lle/Arduino-Robot-Shield/gerber/version1c.TXT

%
M48
M72
T01C0.0276
T02C0.0394
T03C0.0400
T04C0.0470
T05C0.0472
%
T01
X8750Y6300
X8750Y7450
X9250Y7700
X9750Y6700
X11250Y7950
X11750Y8200
X12250Y8950
X9750Y17200
X7250Y19200
X9750Y21200
X7250Y23200
X12250Y23200
X14750Y21200
X16250Y22200
X17250Y21200
X14750Y17200
X12250Y19200
T02
X20250Y18700
X20250Y17700
X20250Y16700
X20250Y15700
X20250Y19700
X20250Y20700
X20250Y22700
X20250Y23700
X20250Y24700
X20250Y25700
X20250Y26700
X20250Y27700
X1250Y27700
X1250Y26700
X1250Y25700
X1250Y24700
X1250Y23700
X1250Y22700
X1250Y21700
X1250Y20700
X1250Y19100
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
