lle/Arduino-Robot-Shield/Arduino_motorSheild.xlsx

Sheet: PCB Specs
PCB Specs
http://www.pcbcart.com/
Material | FR4 | Quantity / Lead time | in 8 days (*) | in 12 days
Material Details | Standard Tg 140C | 20 | $3.32 | $3.17
Board Size (width) * | 70 mm | 5 | $10.95 | $10.45
Quantity * | 20 pcs | 10 | $5.64 | $5.39
Route Process * | -- | 15 | $3.98 | $3.80
Surface Finish | HASL -Hot Air Solder Leveling | 20 | $3.32 | $3.17
Min. Tracing/Spacing | 0.20 mm | 25 | $2.81 | $2.68
Smallest Holes | 0.40 mm | 30 | $2.48 | $2.36
Surface Mount | 1 side | 40 | $2.06 | $1.97
Peelable Soldermask | None | 50 | $1.81 | $1.73
Matt Color (only add to Green or Black) | None | 75 | $1.55 | $1.47
Silkscreen Legend Color | White
Gold Fingers Chamfer | None
Testing | Yes
Date Code Marking * | No
PCB specification file | ???
Layers | 2
Reorder Status * | --
Board Size (height) * | 60 mm
Different Design in Panel * | --
Thickness (Finished Board) | 1.6 mm
Copper Weight (Finished) | 35 um
Min. Annular Ring | 0.30 mm
Holes Numbers | Under 300
Soldermask | Both Sides
Soldermask Color | Blue
Silkscreen Legend | 1 side
Gold Fingers | No
Slots/cutouts in Board | No Slot in Board
UL Marking * | No
Lead Time | in 8 days

Sheet: Inventory
Bill of Material
 | Total Asset | 437.618 |  |  | Test
 | Price/Kit | 10.71008 |  |  | Item Sold | 40
 | Sale Price | $15.99 |  |  | Income | $639.60
 | Profit Margin | $5.28 | 49.29860468% |  | Profit | $201.98
Item | Part No | Store | Price/unit | Qty | Sub-total | Qty/kit | Unit/price in Kit | URL
PCB |  | pcbcart | 2.06 | 40 | $152.54 | 1 | $3.81 | http://www.pcbcart.com/
Diode 1N4001 | 641-1310-1-ND | Digikey | 0.03406 | 500 | $17.03 | 8 | $0.27 | http://www.digikey.ca/product-detail/en/1N4001-G/641-1310-1-ND/1979675
L298 | 497-1395-5-ND | Digikey | 4.0272 | 40 | $161.09 | 1 | $4.03 | http://www.digikey.ca/product-detail/en/L298N/497-1395-5-ND/585918
Male-Male Header (40)(3/kit) | S1212EC-40-ND | Digikey | 0.4577 | 100 | $45.77 | 3 | $1.37 | http://www.digikey.ca/product-detail/en/PREC040SFAN-RC/S1212EC-40-ND/2774934
ScrewBolt Connector (4)(1/kit) | ED2563-ND | Digikey | 0.718 | 50 | $35.90 | 1 | $0.72 | http://www.digikey.ca/product-detail/en/OSTTA040161/ED2563-ND/614513
Capacitor 100uF Electrolytic 25V | 399-6103-ND | Digikey | 0.0804 | 50 | $4.02 | 1 | $0.08 | http://www.digikey.ca/product-detail/en/ESK107M025AE3AA/399-6103-ND/2712509
Capacitor 1uF Ceramic 25V | 445-2857-ND | Digikey | 0.2127 | 100 | $21.27 | 2 | $0.43 | http://www.digikey.ca/product-detail/en/FK24X7R1E105K/445-2857-ND/1008883

Sheet: Kit
Kit Part List
Item
PCB | 1
L298 | 1
Diode | 8
Male-Male Header | 1 | At least 86 positions
ScrewBolt Connector | 1 | 4 bolts
Capacitor 100uF Electrolytic 25V | 1
Capacitor 1uF Ceramic 25V | 2
