lle/Arduino-Robot-Shield/version1c.brd

## EAGLE design version1c.brd (2014-05-17)

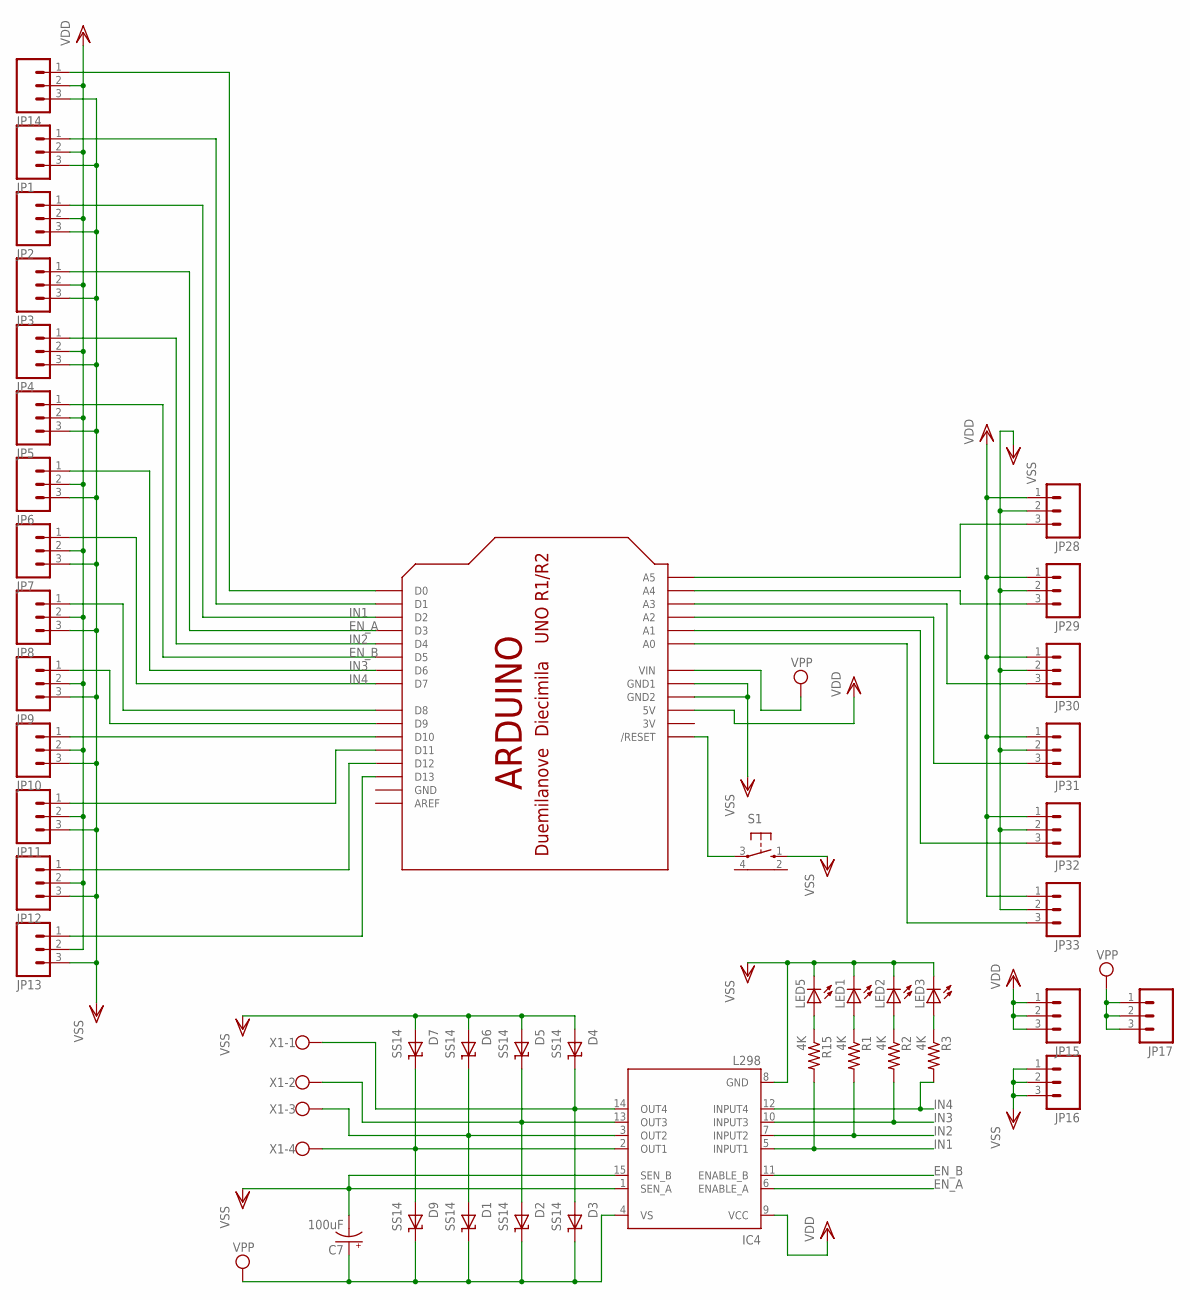
[picture p1: schematic version1c.sch]

Parts:
C7: 100uF; 153CLV-0605
D1, D2, D3, D4, D5, D6, D7, D9: SS14; SMA
IC4: L298; MULTIWATT-15
JP1, JP2, JP3, JP4, JP5, JP6, JP7, JP8, JP9, JP10, JP11, JP12, JP13, JP14, JP15, JP16, JP17, JP28, JP29, JP30, JP31, JP32, JP33: M03PTH; 1X03
LED1, LED2, LED3, LED5: LEDCHIP-LED0805; CHIP-LED0805
R1, R2, R3, R15: 4K; R0805
S1: 10-XX-RPAD; B3F-10XX-RPAD
U$1: ARDUINO-NOHOLE
X1: W237-4

Connections:
3V: U$1.3V
EN_A: IC4.6 (ENABLE_A), JP3.1, U$1.D3
EN_B: IC4.11 (ENABLE_B), JP5.1, U$1.D5
GND: U$1.GND
IN1: IC4.5 (INPUT1), JP2.1, R15.2, U$1.D2
IN2: IC4.7 (INPUT2), JP4.1, R1.2, U$1.D4
IN3: IC4.10 (INPUT3), JP6.1, R2.2, U$1.D6
IN4: IC4.12 (INPUT4), JP7.1, R3.2, U$1.D7
unnamed: JP13.1, U$1.D13
unnamed: JP12.1, U$1.D12
unnamed: JP28.3, U$1.A5
unnamed: JP11.1, U$1.D11
unnamed: JP10.1, U$1.D10
unnamed: JP29.3, U$1.A4
unnamed: JP9.1, U$1.D9
unnamed: JP8.1, U$1.D8
unnamed: JP30.3, U$1.A3
unnamed: LED3.A, R3.1
unnamed: LED2.A, R2.1
unnamed: JP31.3, U$1.A2
unnamed: LED1.A, R1.1
unnamed: LED5.A, R15.1
unnamed: JP33.3, U$1.A0
unnamed: JP32.3, U$1.A1
unnamed: JP1.1, U$1.D1
unnamed: JP14.1, U$1.D0
unnamed: S1.3, U$1.RESET (/RESET)
unnamed: D7.P$1 (K), D9.P$2 (A), IC4.2 (OUT1), X1.4
unnamed: D1.P$2 (A), D6.P$1 (K), IC4.3 (OUT2), X1.3
unnamed: D2.P$2 (A), D5.P$1 (K), IC4.13 (OUT3), X1.2
unnamed: D3.P$2 (A), D4.P$1 (K), IC4.14 (OUT4), X1.1
VDD: IC4.9 (VCC), JP1.2, JP2.2, JP3.2, JP4.2, JP5.2, JP6.2, JP7.2, JP8.2, JP9.2, JP10.2, JP11.2, JP12.2, JP13.2, JP14.2, JP15.1, JP15.2, JP15.3, JP28.1, JP29.1, JP30.1, JP31.1, JP32.1, JP33.1, U$1.5V
VPP: C7.+, D1.P$1 (K), D2.P$1 (K), D3.P$1 (K), D9.P$1 (K), IC4.4 (VS), JP17.1, JP17.2, JP17.3, U$1.VIN
VSS: C7.-, D4.P$2 (A), D5.P$2 (A), D6.P$2 (A), D7.P$2 (A), IC4.1 (SEN_A), IC4.8 (GND), IC4.15 (SEN_B), JP1.3, JP2.3, JP3.3, JP4.3, JP5.3, JP6.3, JP7.3, JP8.3, JP9.3, JP10.3, JP11.3, JP12.3, JP13.3, JP14.3, JP16.1, JP16.2, JP16.3, JP28.2, JP29.2, JP30.2, JP31.2, JP32.2, JP33.2, LED1.C, LED2.C, LED3.C, LED5.C, S1.1 (S), U$1.GND1, U$1.GND2

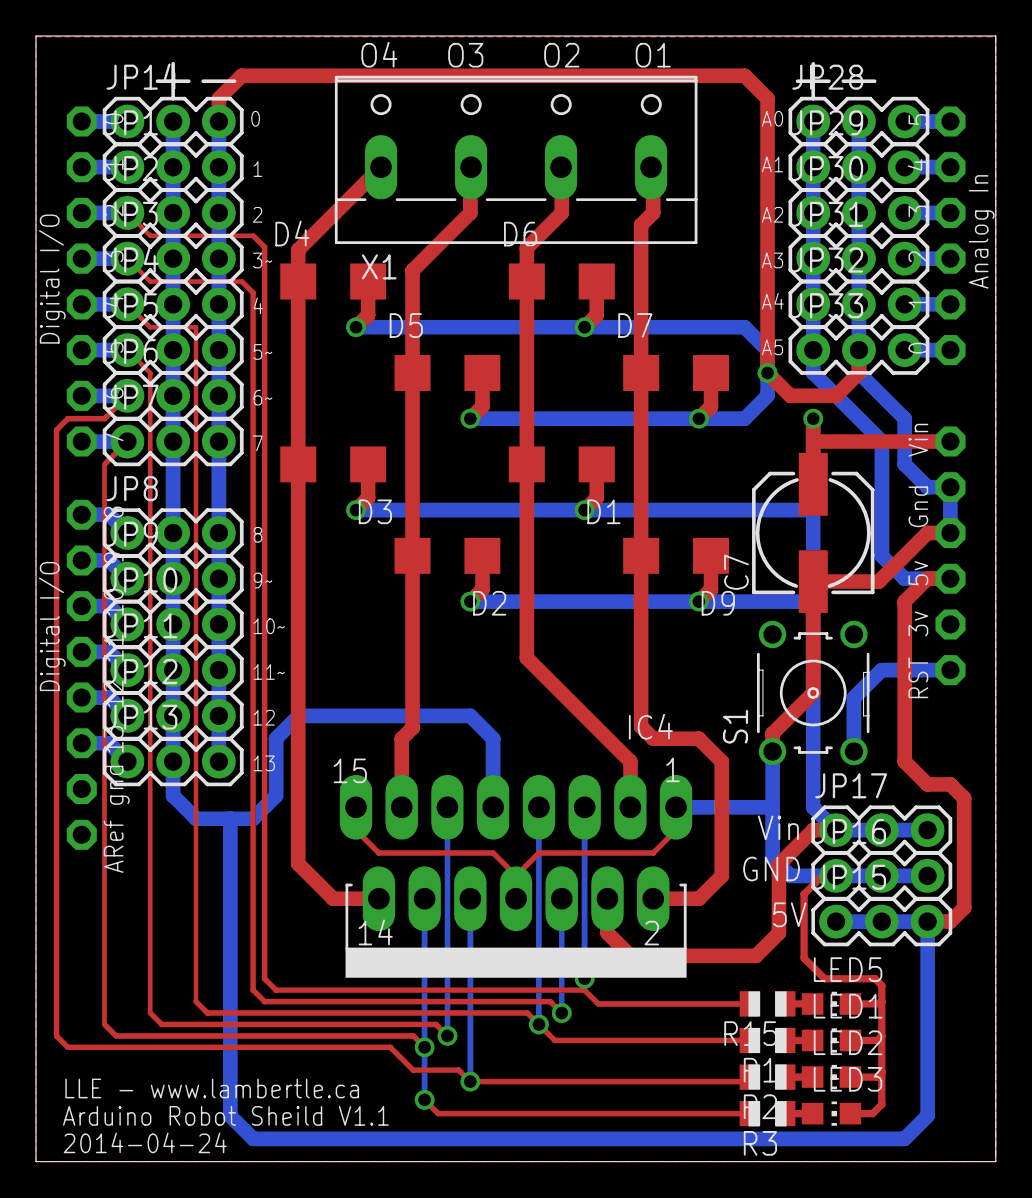
[picture p2: board version1c.brd from above]

Board: 2 copper layers, 53.3 x 62.5 mm, 44 parts (0 on the bottom side), 32 nets.
