lle/Arduino-Robot-Shield/version1.brd

## EAGLE design version1.brd (2014-04-19)

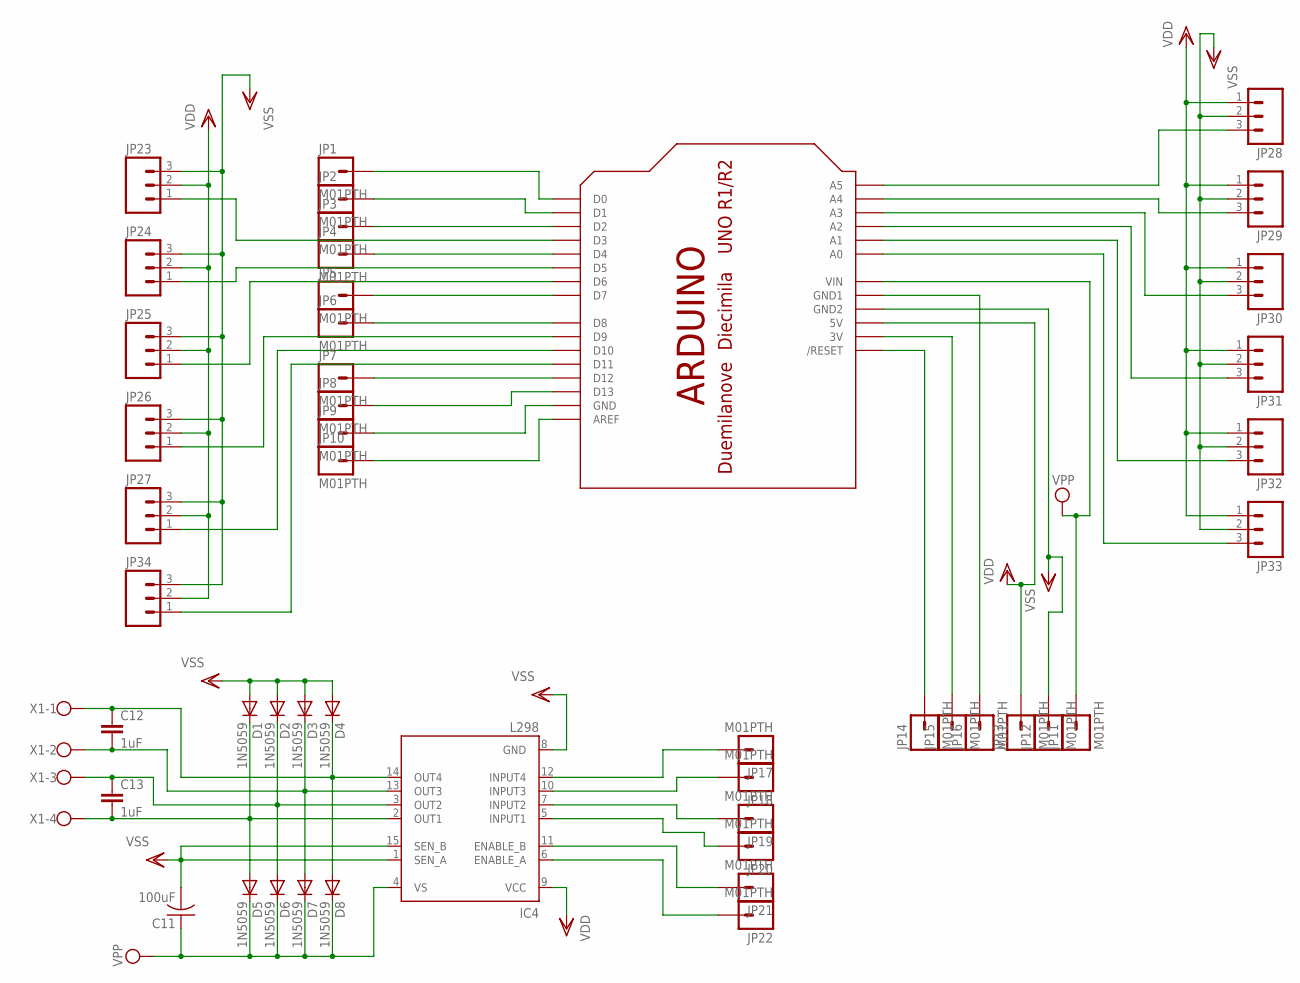
[picture p3: schematic version1.sch]

Parts:
C11: 100uF; C050-025X075
C12, C13: 1uF; C050-025X075
D1, D2, D3, D4, D5, D6, D7, D8: 1N5059; DO204-10
IC4: L298; MULTIWATT-15
JP1, JP2, JP3, JP4, JP5, JP6, JP7, JP8, JP9, JP10, JP11, JP12, JP13, JP14, JP15, JP16, JP17, JP18, JP19, JP20, JP21, JP22: M01PTH; 1X01
JP23, JP24, JP25, JP26, JP27, JP28, JP29, JP30, JP31, JP32, JP33, JP34: M03PTH; 1X03
U$1: ARDUINO-NOHOLE
X1: W237-4

Connections:
unnamed: JP1.1, U$1.D0
unnamed: JP2.1, U$1.D1
unnamed: JP28.3, U$1.A5
unnamed: JP3.1, U$1.D2
unnamed: JP4.1, U$1.D4
unnamed: JP29.3, U$1.A4
unnamed: JP5.1, U$1.D7
unnamed: JP6.1, U$1.D8
unnamed: JP30.3, U$1.A3
unnamed: JP7.1, U$1.D12
unnamed: JP8.1, U$1.D13
unnamed: JP31.3, U$1.A2
unnamed: JP9.1, U$1.GND
unnamed: JP23.1, U$1.D3
unnamed: JP24.1, U$1.D5
unnamed: JP33.3, U$1.A0
unnamed: JP32.3, U$1.A1
unnamed: JP10.1, U$1.AREF
unnamed: JP14.1, U$1.RESET (/RESET)
unnamed: JP25.1, U$1.D6
unnamed: JP15.1, U$1.3V
unnamed: JP16.1, U$1.GND1
unnamed: JP27.1, U$1.D10
unnamed: C13.2, D1.C, D5.A, IC4.2 (OUT1), X1.4
unnamed: C13.1, D2.C, D6.A, IC4.3 (OUT2), X1.3
unnamed: JP34.1, U$1.D11
unnamed: C12.2, D3.C, D7.A, IC4.13 (OUT3), X1.2
unnamed: C12.1, D4.C, D8.A, IC4.14 (OUT4), X1.1
unnamed: IC4.6 (ENABLE_A), JP22.1
unnamed: JP26.1, U$1.D9
unnamed: IC4.11 (ENABLE_B), JP21.1
unnamed: IC4.12 (INPUT4), JP17.1
unnamed: IC4.10 (INPUT3), JP18.1
unnamed: IC4.7 (INPUT2), JP19.1
unnamed: IC4.5 (INPUT1), JP20.1
VDD: IC4.9 (VCC), JP13.1, JP23.2, JP24.2, JP25.2, JP26.2, JP27.2, JP28.1, JP29.1, JP30.1, JP31.1, JP32.1, JP33.1, JP34.2, U$1.5V
VPP: C11.1, D5.C, D6.C, D7.C, D8.C, IC4.4 (VS), JP11.1, U$1.VIN
VSS: C11.2, D1.A, D2.A, D3.A, D4.A, IC4.1 (SEN_A), IC4.8 (GND), IC4.15 (SEN_B), JP12.1, JP23.3, JP24.3, JP25.3, JP26.3, JP27.3, JP28.2, JP29.2, JP30.2, JP31.2, JP32.2, JP33.2, JP34.3, U$1.GND2

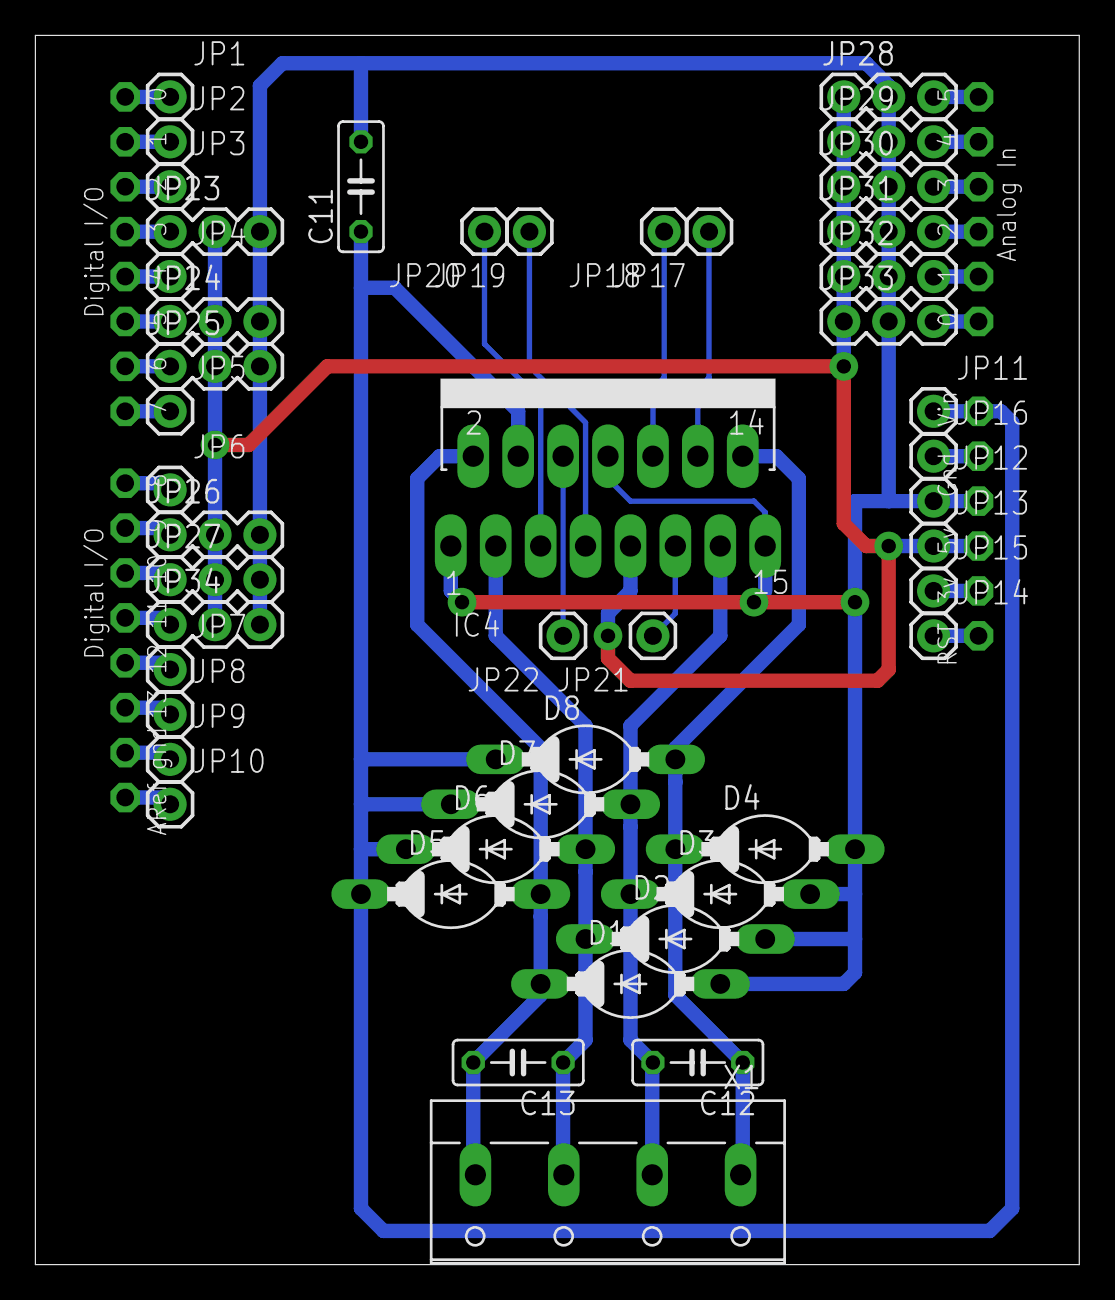
[picture p4: board version1.brd from above]

Board: 2 copper layers, 59.0 x 69.5 mm, 48 parts (0 on the bottom side), 38 nets.
