lle/Arduino-Robot-Shield/(commit log)

2014-04-19 Edited old 2013 version
    Now with LED indicator
    surface mount diodes and resistors
    [Arduino_motorSheild.xlsx, version1.brd, version1.sch, version1b-dump.brd, version1b-dump2.brd, version1b.brd, version1b.sch]
2014-05-17 Version 1c Created
    Added debug LED and surface mount components
    [version1c.GBL, version1c.GBO, version1c.GBS, version1c.GKO, version1c.GTL, version1c.GTO, version1c.GTP, version1c.GTS]
